wsu-roboracer/traffic-signal-head/signal-head-dense/bottom.png

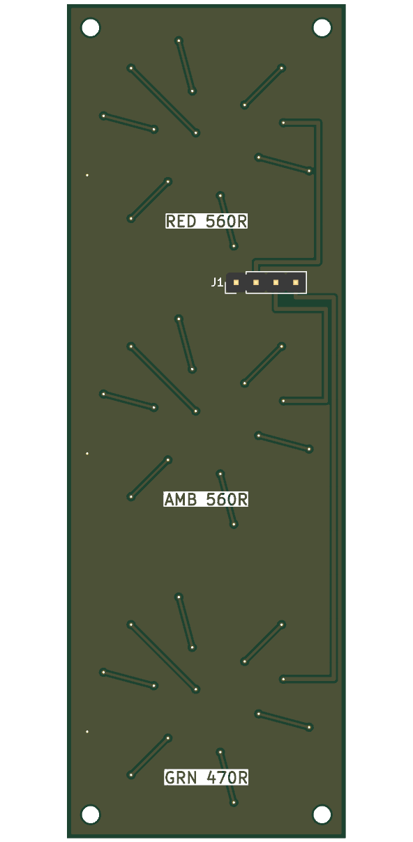
signal-head-dense/bottom.png
