wsu-roboracer/traffic-signal-head/signal-head-dense/top.png

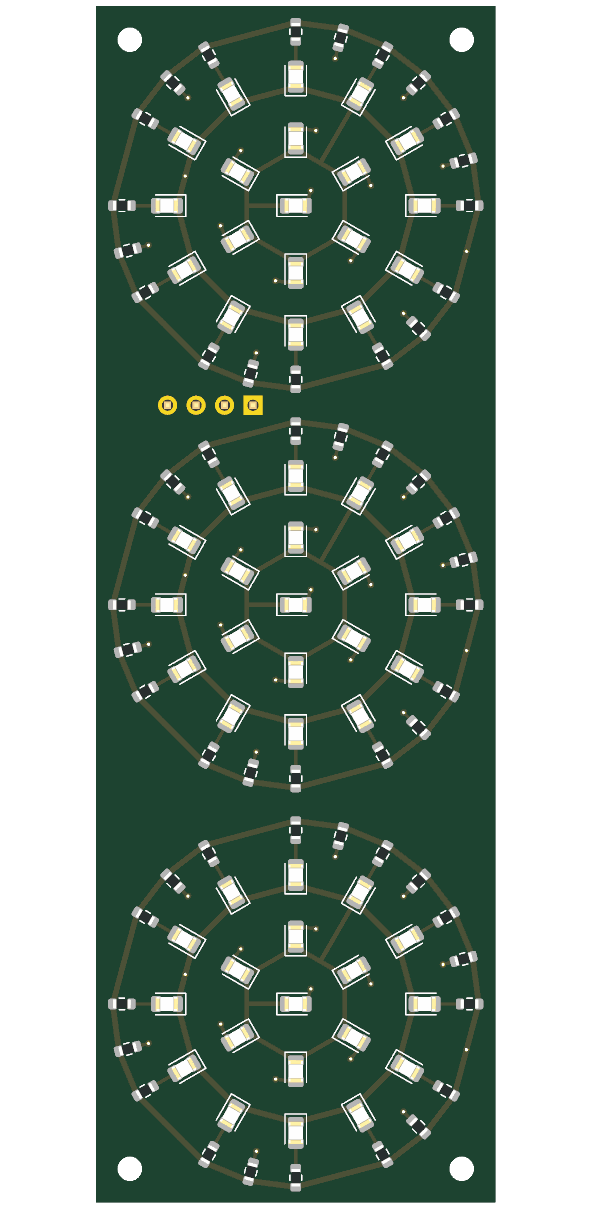
signal-head-dense/top.png
