wsu-roboracer/traffic-signal-head/signal-head/bottom.png

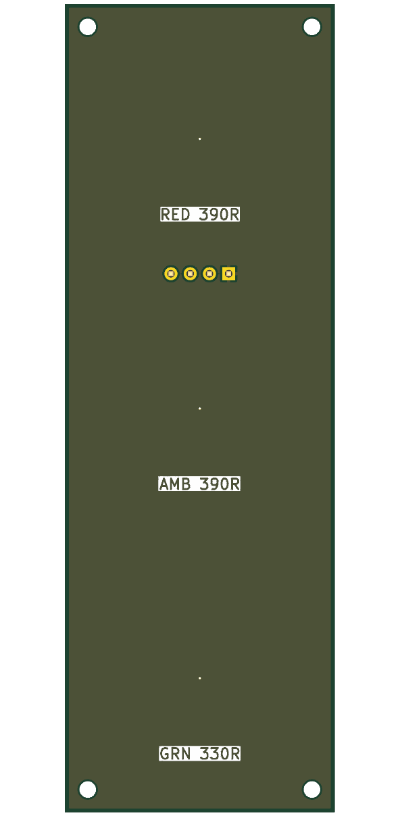
signal-head/bottom.png
