wsu-roboracer/traffic-signal-head/signal-head/top.png

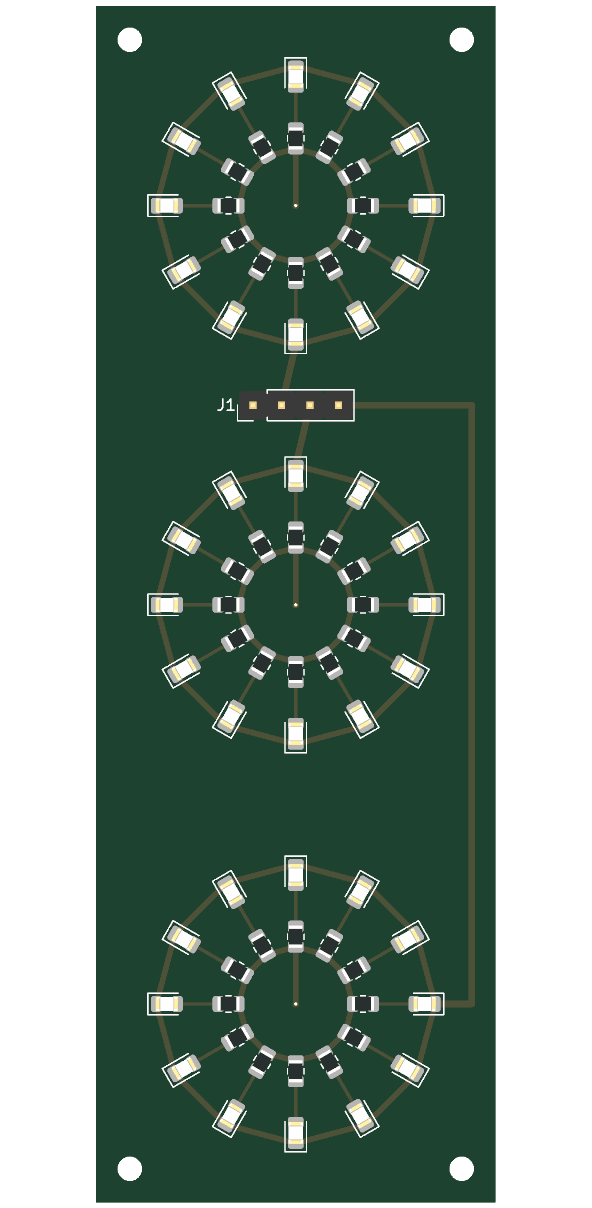
signal-head/top.png
