wsu-roboracer/traffic-signal-head/signal-head-dense/bom.csv

Reference | Value | Footprint | LCSC
D1-D19 | KT-0805R | LED_SMD:LED_0805_2012Metric | C2295
D20-D38 | KT-0805Y | LED_SMD:LED_0805_2012Metric | C2296
D39-D57 | KT-0805G | LED_SMD:LED_0805_2012Metric | C2297
H1-H4 | M2 | MountingHole:MountingHole_2.2mm_M2
J1 | Conn_01x04 | Connector_PinHeader_2.54mm:PinHeader_1x04_P2.54mm_Vertical
R1-R38 | 560 | Resistor_SMD:R_0603_1608Metric
R39-R57 | 470 | Resistor_SMD:R_0603_1608Metric
