wsu-roboracer/traffic-signal-head/signal-head/jlcpcb/signal-head-bom.csv

Comment | Designator | Footprint | LCSC Part #
KT-0805R | D1,D2,D3,D4,D5,D6,D7,D8,D9,D10,D11,D12 | LED_0805_2012Metric | C2295
KT-0805Y | D13,D14,D15,D16,D17,D18,D19,D20,D21,D22,D23,D24 | LED_0805_2012Metric | C2296
KT-0805G | D25,D26,D27,D28,D29,D30,D31,D32,D33,D34,D35,D36 | LED_0805_2012Metric | C2297
390 | R1,R2,R3,R4,R5,R6,R7,R8,R9,R10,R11,R12,R13,R14,R15,R16,R17,R18,R19,R20,R21,R22,R23,R24 | R_0805_2012Metric | C17655
330 | R25,R26,R27,R28,R29,R30,R31,R32,R33,R34,R35,R36 | R_0805_2012Metric | C17630
