wsu-roboracer/traffic-signal-head/signal-head-dense/signal-head-dense.kicad_pcb

## KiCad design signal-head-dense/signal-head-dense.kicad_pcb (2026-10-28)

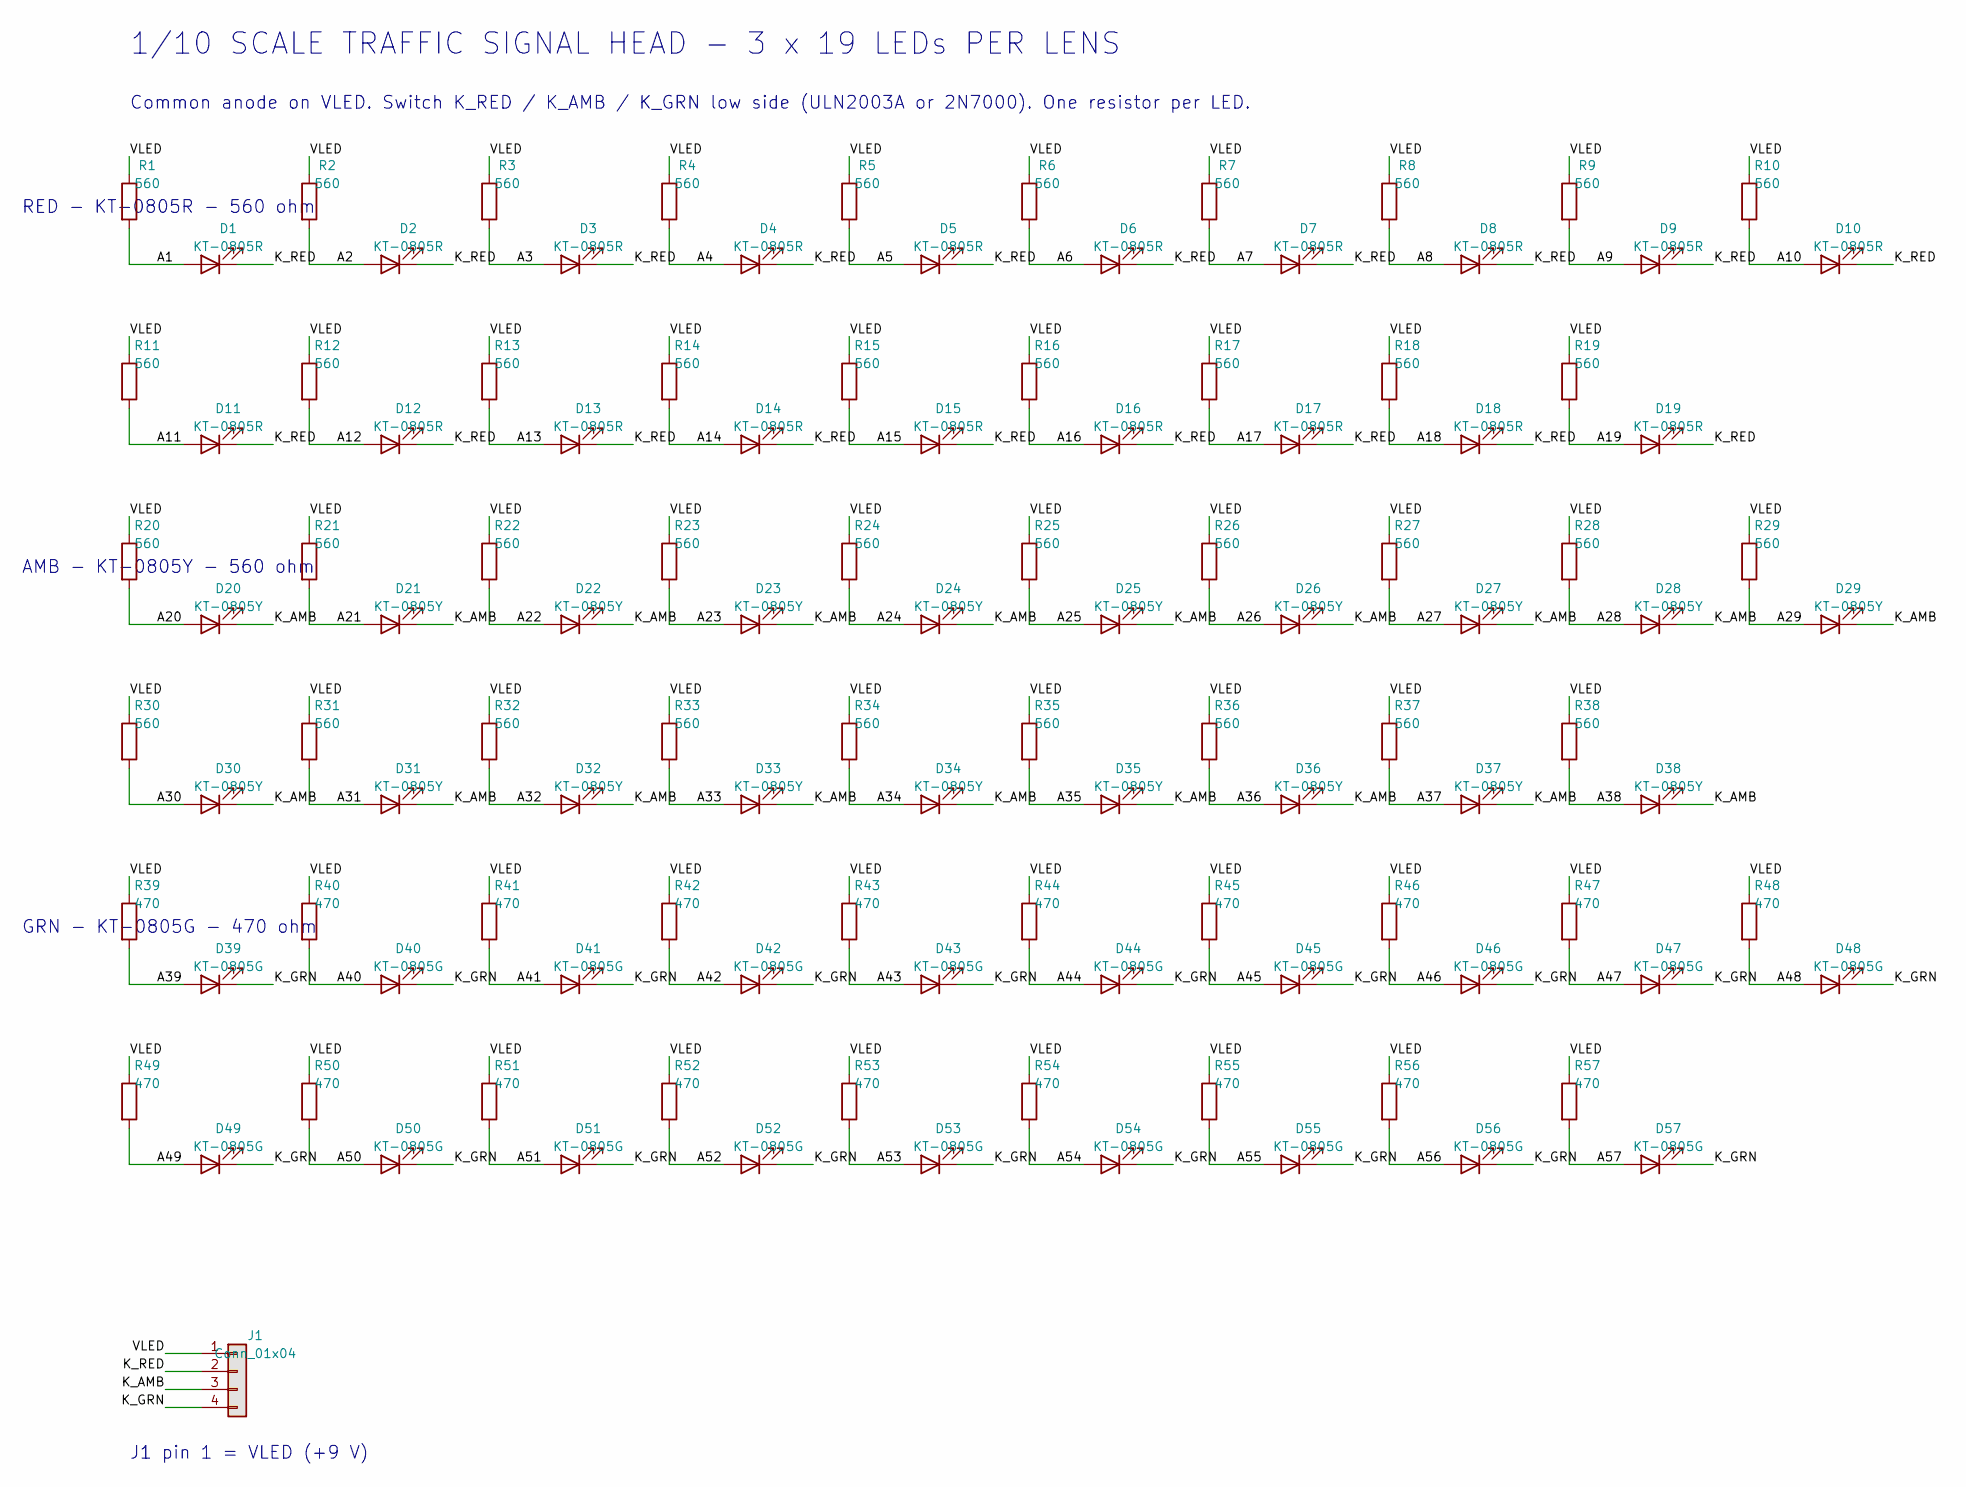
[picture p5: schematic signal-head-dense.kicad_sch]

Parts:
D1, D2, D3, D4, D5, D6, D7, D8, D9, D10, D11, D12, D13, D14, D15, D16, D17, D18, D19: KT-0805R; LED_0805_2012Metric; LCSC C2295
D20, D21, D22, D23, D24, D25, D26, D27, D28, D29, D30, D31, D32, D33, D34, D35, D36, D37, D38: KT-0805Y; LED_0805_2012Metric; LCSC C2296
D39, D40, D41, D42, D43, D44, D45, D46, D47, D48, D49, D50, D51, D52, D53, D54, D55, D56, D57: KT-0805G; LED_0805_2012Metric; LCSC C2297
J1: Conn_01x04; PinHeader_1x04_P2.54mm_Vertical
R1, R2, R3, R4, R5, R6, R7, R8, R9, R10, R11, R12, R13, R14, R15, R16, R17, R18, R19, R20, R21, R22, R23, R24, R25, R26, R27, R28, R29, R30, R31, R32, R33, R34, R35, R36, R37, R38: 560; R_0603_1608Metric; LCSC C23204
R39, R40, R41, R42, R43, R44, R45, R46, R47, R48, R49, R50, R51, R52, R53, R54, R55, R56, R57: 470; R_0603_1608Metric; LCSC C23179

Connections:
A1: D1.2 (A), R1.2
A2: D2.2 (A), R2.2
A3: D3.2 (A), R3.2
A4: D4.2 (A), R4.2
A5: D5.2 (A), R5.2
A6: D6.2 (A), R6.2
A7: D7.2 (A), R7.2
A8: D8.2 (A), R8.2
A9: D9.2 (A), R9.2
A10: D10.2 (A), R10.2
A11: D11.2 (A), R11.2
A12: D12.2 (A), R12.2
A13: D13.2 (A), R13.2
A14: D14.2 (A), R14.2
A15: D15.2 (A), R15.2
A16: D16.2 (A), R16.2
A17: D17.2 (A), R17.2
A18: D18.2 (A), R18.2
A19: D19.2 (A), R19.2
A20: D20.2 (A), R20.2
A21: D21.2 (A), R21.2
A22: D22.2 (A), R22.2
A23: D23.2 (A), R23.2
A24: D24.2 (A), R24.2
A25: D25.2 (A), R25.2
A26: D26.2 (A), R26.2
A27: D27.2 (A), R27.2
A28: D28.2 (A), R28.2
A29: D29.2 (A), R29.2
A30: D30.2 (A), R30.2
A31: D31.2 (A), R31.2
A32: D32.2 (A), R32.2
A33: D33.2 (A), R33.2
A34: D34.2 (A), R34.2
A35: D35.2 (A), R35.2
A36: D36.2 (A), R36.2
A37: D37.2 (A), R37.2
A38: D38.2 (A), R38.2
A39: D39.2 (A), R39.2
A40: D40.2 (A), R40.2
A41: D41.2 (A), R41.2
A42: D42.2 (A), R42.2
A43: D43.2 (A), R43.2
A44: D44.2 (A), R44.2
A45: D45.2 (A), R45.2
A46: D46.2 (A), R46.2
A47: D47.2 (A), R47.2
A48: D48.2 (A), R48.2
A49: D49.2 (A), R49.2
A50: D50.2 (A), R50.2
A51: D51.2 (A), R51.2
A52: D52.2 (A), R52.2
A53: D53.2 (A), R53.2
A54: D54.2 (A), R54.2
A55: D55.2 (A), R55.2
A56: D56.2 (A), R56.2
A57: D57.2 (A), R57.2
K_AMB: D20.1 (K), D21.1 (K), D22.1 (K), D23.1 (K), D24.1 (K), D25.1 (K), D26.1 (K), D27.1 (K), D28.1 (K), D29.1 (K), D30.1 (K), D31.1 (K), D32.1 (K), D33.1 (K), D34.1 (K), D35.1 (K), D36.1 (K), D37.1 (K), D38.1 (K), J1.3
K_GRN: D39.1 (K), D40.1 (K), D41.1 (K), D42.1 (K), D43.1 (K), D44.1 (K), D45.1 (K), D46.1 (K), D47.1 (K), D48.1 (K), D49.1 (K), D50.1 (K), D51.1 (K), D52.1 (K), D53.1 (K), D54.1 (K), D55.1 (K), D56.1 (K), D57.1 (K), J1.4
K_RED: D1.1 (K), D2.1 (K), D3.1 (K), D4.1 (K), D5.1 (K), D6.1 (K), D7.1 (K), D8.1 (K), D9.1 (K), D10.1 (K), D11.1 (K), D12.1 (K), D13.1 (K), D14.1 (K), D15.1 (K), D16.1 (K), D17.1 (K), D18.1 (K), D19.1 (K), J1.2
VLED: J1.1, R1.1, R2.1, R3.1, R4.1, R5.1, R6.1, R7.1, R8.1, R9.1, R10.1, R11.1, R12.1, R13.1, R14.1, R15.1, R16.1, R17.1, R18.1, R19.1, R20.1, R21.1, R22.1, R23.1, R24.1, R25.1, R26.1, R27.1, R28.1, R29.1, R30.1, R31.1, R32.1, R33.1, R34.1, R35.1, R36.1, R37.1, R38.1, R39.1, R40.1, R41.1, R42.1, R43.1, R44.1, R45.1, R46.1, R47.1, R48.1, R49.1, R50.1, R51.1, R52.1, R53.1, R54.1, R55.1, R56.1, R57.1

Notes on the sheet:
1/10 SCALE TRAFFIC SIGNAL HEAD - 3 x 19 LEDs PER LENS
Common anode on VLED. Switch K_RED / K_AMB / K_GRN low side (ULN2003A or 2N7000). One resistor per LED.
RED - KT-0805R - 560 ohm
AMB - KT-0805Y - 560 ohm
GRN - KT-0805G - 470 ohm
J1 pin 1 = VLED (+9 V)

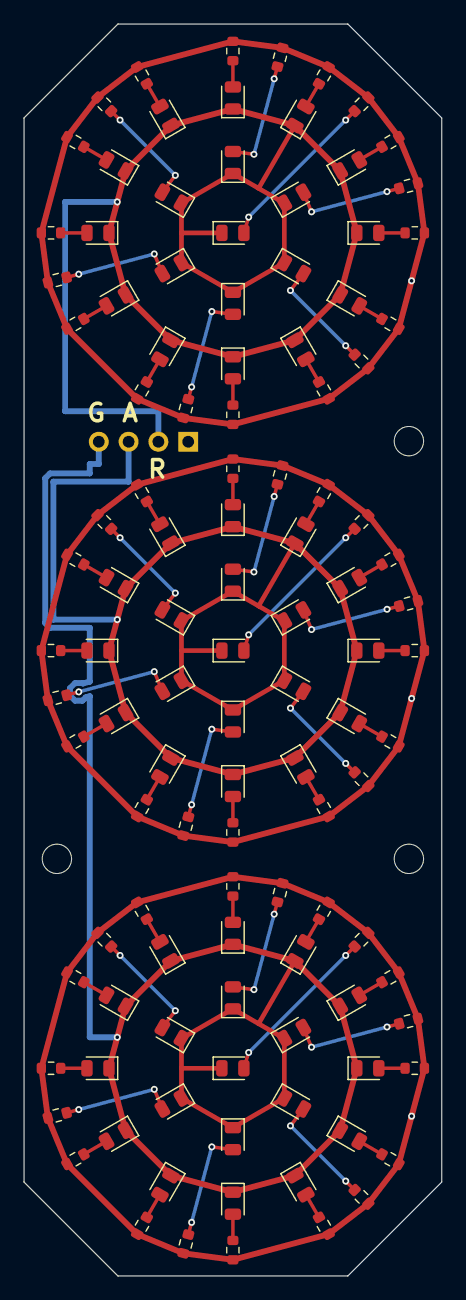
[picture p6: board signal-head-dense.kicad_pcb from above]

Board: 2 copper layers, 35.6 x 106.7 mm, 115 parts (1 on the bottom side), 61 nets.
